larry-athey/larrys-cmd-ctrl/Firmware/README.md

# Firmware Updating

_Keep in mind that this guide and firmware files only serve as an example, there is no way that I can provide firmware files to cover every possible use case. There are brushed motor controllers and stepper motor controllers, a person may or may not be using a GPIO expansion module, there's no way for me to know how many RGB LEDs a person intends to use, etc. Anybody can create their own firmware .bin files from the Arduino IDE by clicking on **Sketch** in the menu bar and then selecting **Export Compiled Binary**._

_This example is being provided for those who have a lot of LCC Slaves and it's not plausible or possible to connect each of them to a USB cable in order to flash them the conventional way. The two firmware files that I do provide here are stock builds of the latest source code without the GPIO expansion module add-on._

---

To put an LCC Slave into firmware update mode, open it in the Mission Control device editor and click the **Update Firmware** button at the bottom of the editor pane and follow the instructions on your screen.

The LCC Slave will start up a WiFi access point with the SSID **"LCC-Slave-Update"** and the password to connect is **"12345678"**.

Now open this URL: **http://192.168.4.1**

<br>

If you are unable to connect, check to make sure that your device pulled an IP address from the LCC Slave. If it does not pull one, you will need to manually configure a static IP address on your device. Here are settings that will work for you if you encounter this problem.

Address: 192.168.4.100<br>
Subnet Mask: 255.255.255.0<br>
Gateway: 192.168.4.1<br>
DNS: 192.168.4.1<br>

Click on the button to browse to your **lcc-slave-(device type).bin** file and click the blue button to start the upload.

Once the upload progress bar has completed, the LCC Slave will reboot and will be running the new firmware.
