larry-athey/larrys-cmd-ctrl/Diagrams/LCC Slave PCB (type 1)/LCC-Slave-Type-1_PCB_layers.png

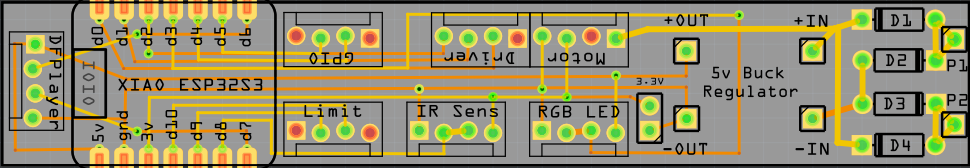
Diagrams/LCC Slave PCB (type 1)/LCC-Slave-Type-1_PCB_layers.png
