larry-athey/larrys-cmd-ctrl/Diagrams/LCC Slave PCB (type 2)/LCC-Slave-Type-2_PCB_top.png

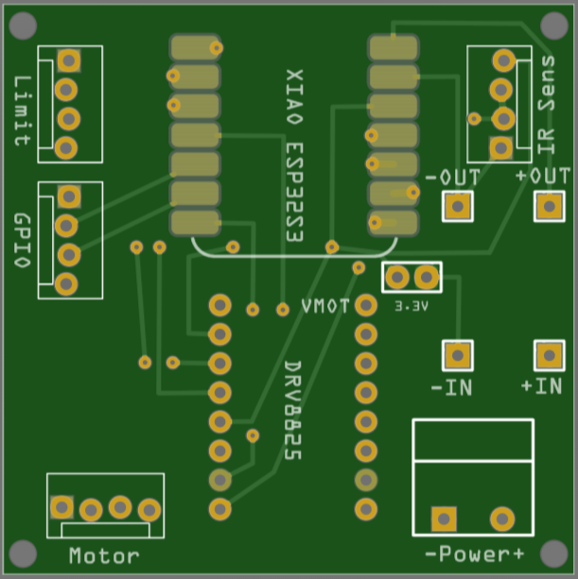
Diagrams/LCC Slave PCB (type 2)/LCC-Slave-Type-2_PCB_top.png
