larry-athey/larrys-cmd-ctrl/Diagrams/LCC Transponder/LCC-Transponder_bottom.png

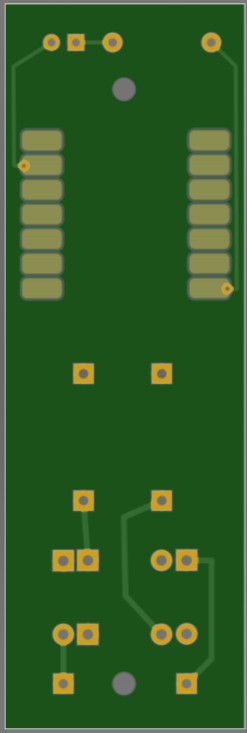
Diagrams/LCC Transponder/LCC-Transponder_bottom.png
