larry-athey/larrys-cmd-ctrl/Diagrams/LCC Transponder/LCC-Transponder_layers.png

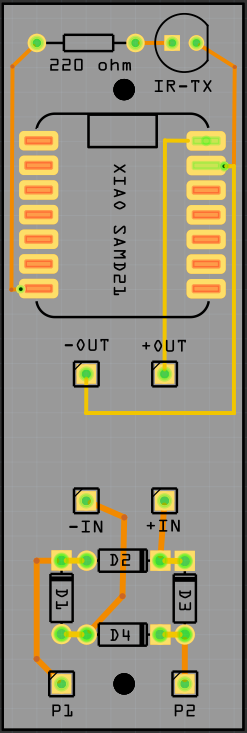
Diagrams/LCC Transponder/LCC-Transponder_layers.png
