larry-athey/larrys-cmd-ctrl/Diagrams/LCC Transponder/LCC-Transponder_top.png

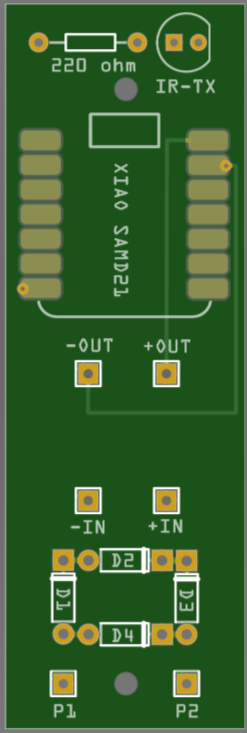
Diagrams/LCC Transponder/LCC-Transponder_top.png
