larry-athey/larrys-cmd-ctrl/Diagrams/Screenshots/Commands.png

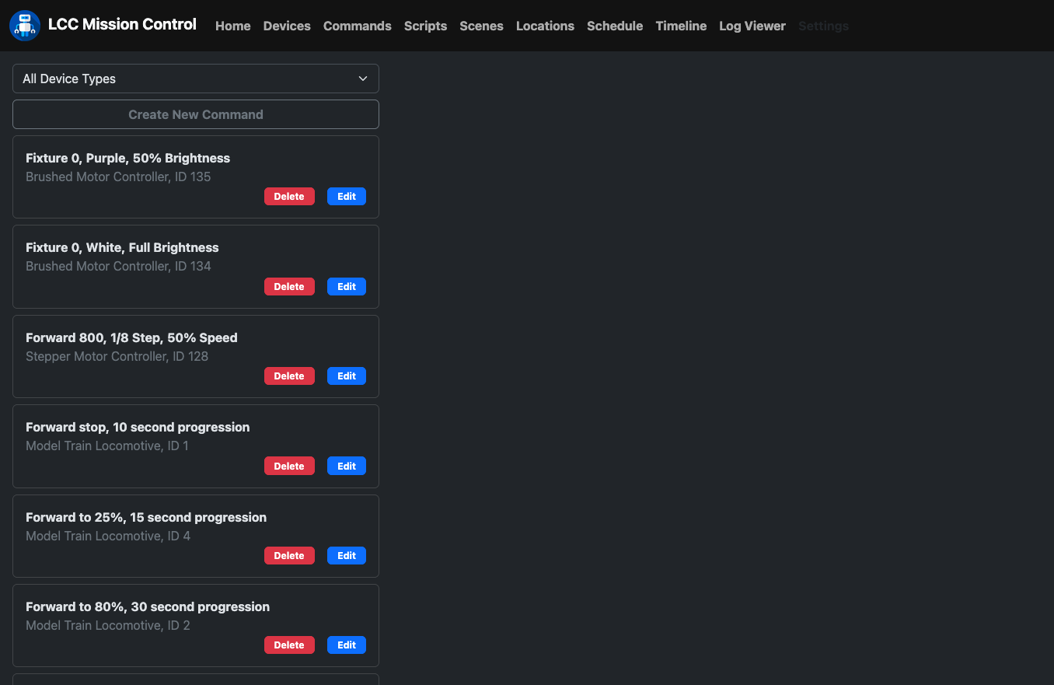
Diagrams/Screenshots/Commands.png
