larry-athey/larrys-cmd-ctrl/Diagrams/Screenshots/Log Viewer.png

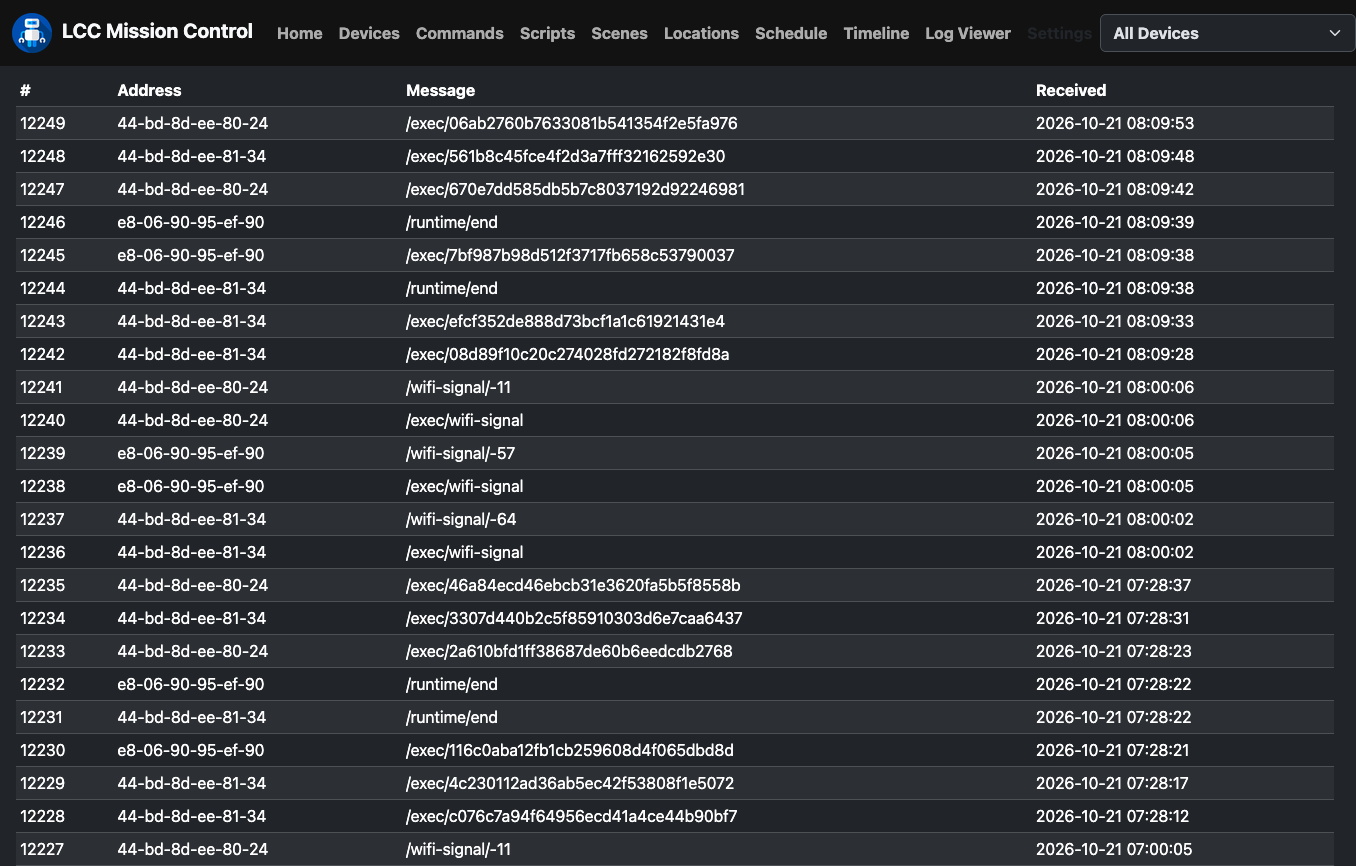
Diagrams/Screenshots/Log Viewer.png
