larry-athey/larrys-cmd-ctrl/Diagrams/Screenshots/Mobile UI.jpg

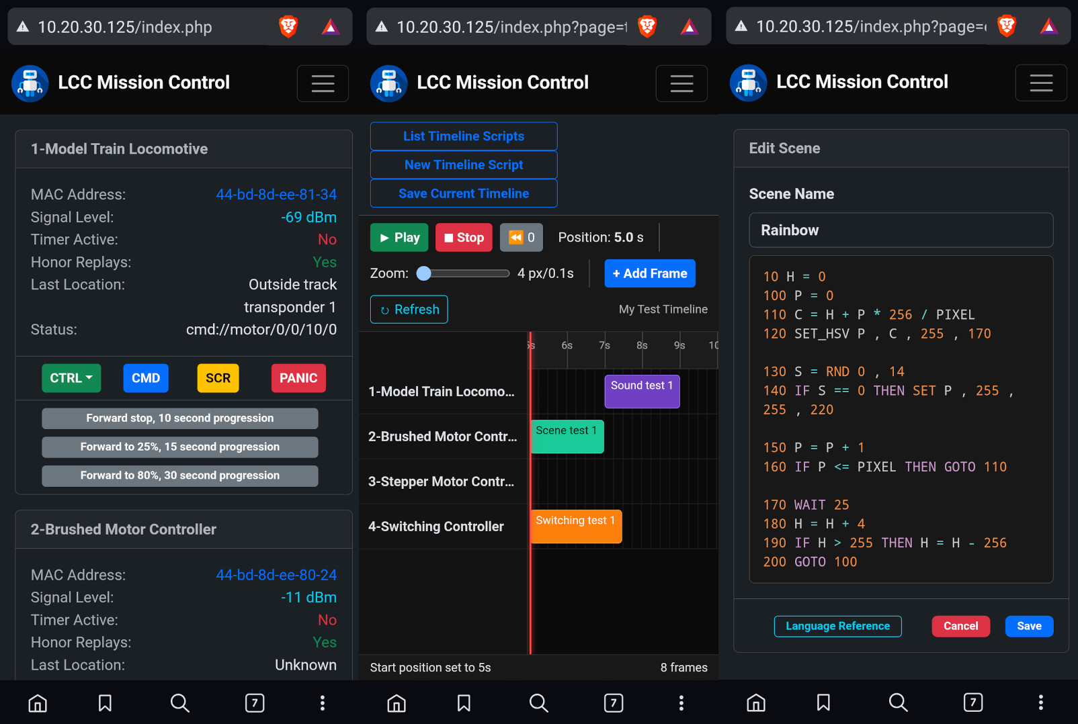
Diagrams/Screenshots/Mobile UI.jpg
