larry-athey/larrys-cmd-ctrl/Diagrams/Screenshots/Scene Editor.png

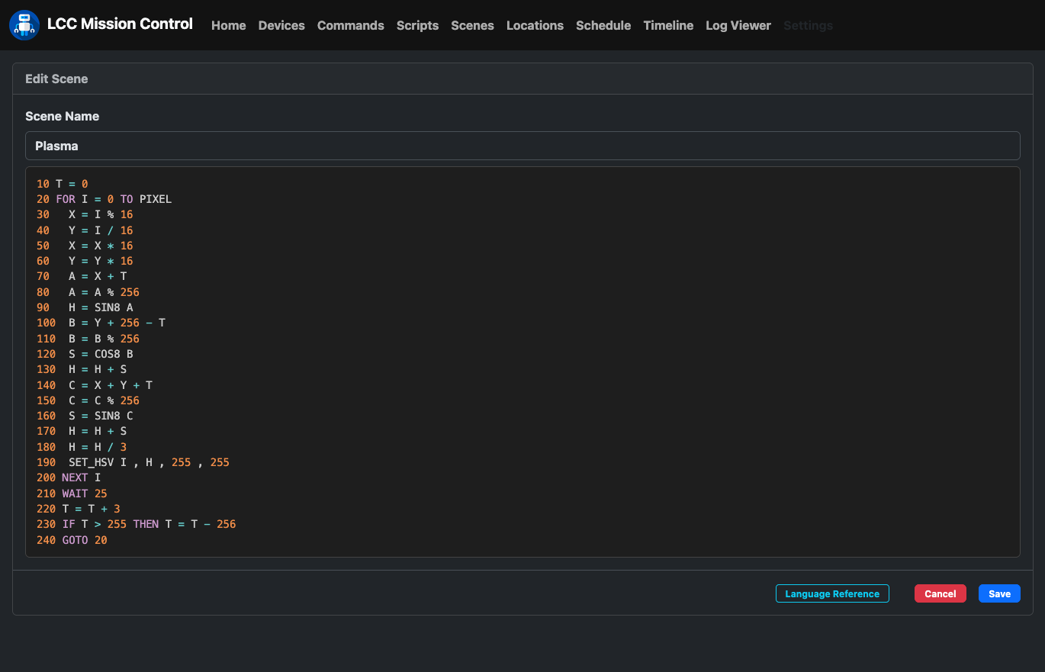
Diagrams/Screenshots/Scene Editor.png
