larry-athey/larrys-cmd-ctrl/Diagrams/Server Driver/Server-Driver-PCB_bottom.png

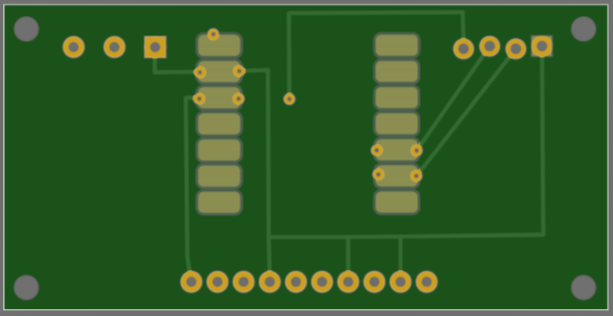
Diagrams/Server Driver/Server-Driver-PCB_bottom.png
