larry-athey/larrys-cmd-ctrl/Diagrams/Server Driver/Server-Driver-PCB_layers.png

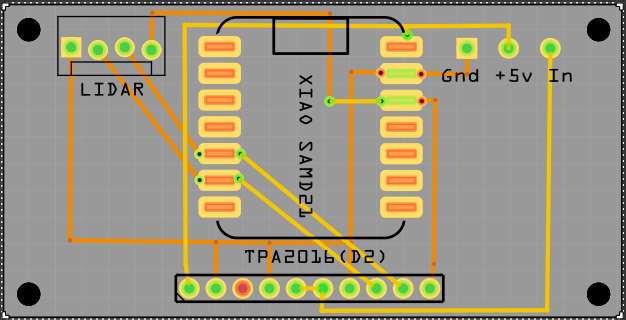
Diagrams/Server Driver/Server-Driver-PCB_layers.png
