larry-athey/larrys-cmd-ctrl/Diagrams/Server Driver/Server-Driver-PCB_top.png

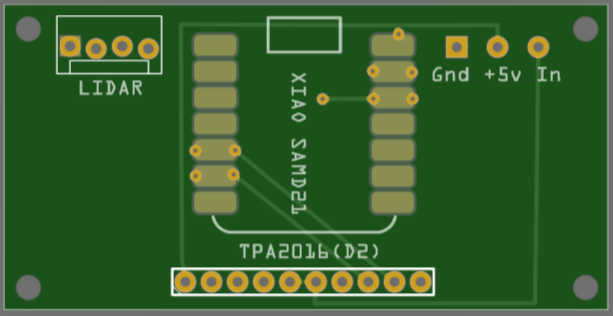
Diagrams/Server Driver/Server-Driver-PCB_top.png
