larry-athey/larrys-cmd-ctrl/3D-Models/Transponder-Top.stl

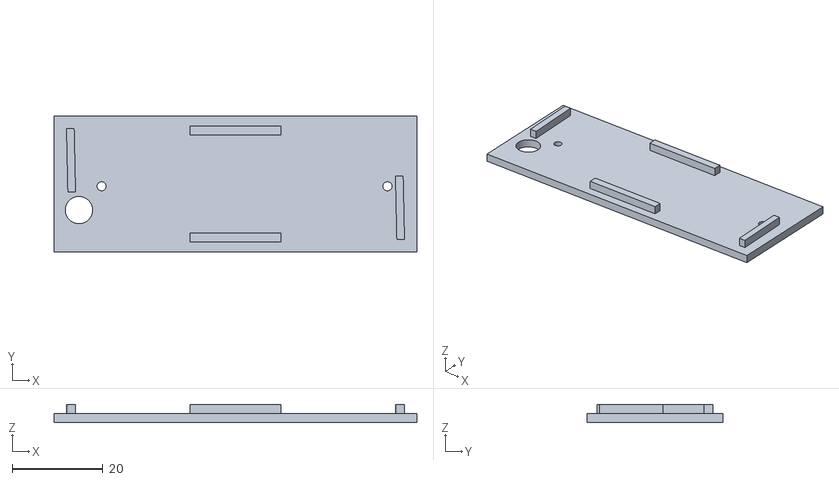
[picture p18: CAD file, 2026-10-28]
3D-Models/Transponder-Top.stl
80.0 x 30.0 x 4.00
