larry-athey/larrys-cmd-ctrl/3D-Models/Transponder-Bottom.stl

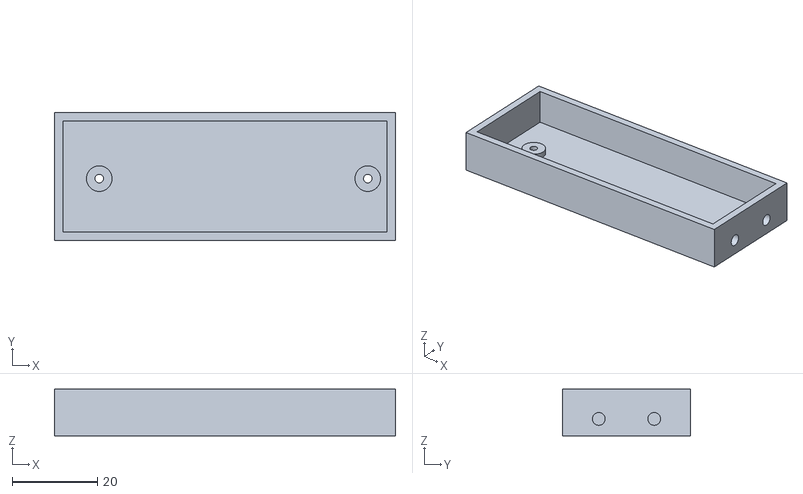
[picture p19: CAD file, 2026-10-28]
3D-Models/Transponder-Bottom.stl
80.0 x 30.0 x 11.0
