larry-athey/larrys-cmd-ctrl/3D-Models/Matchbox-Speaker-Back.stl

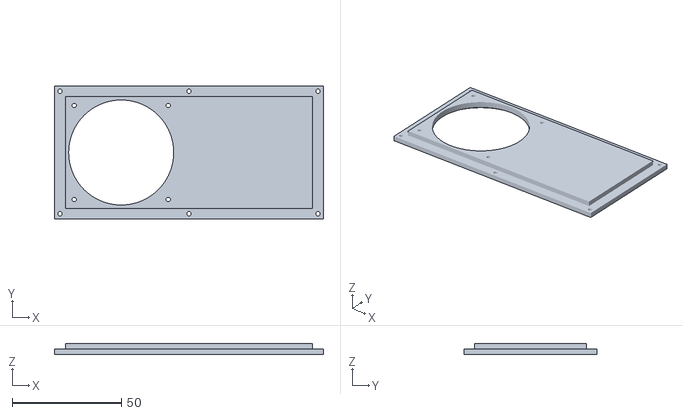
[picture p20: CAD file, 2026-10-16]
3D-Models/Matchbox-Speaker-Back.stl
123.0 x 61.0 x 5.00
