larry-athey/larrys-cmd-ctrl/3D-Models/Matchbox-Speaker-Front.stl

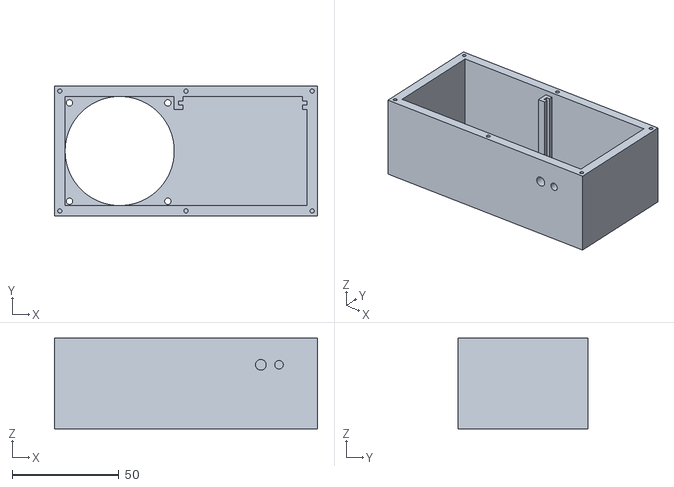
[picture p21: CAD file, 2026-10-16]
3D-Models/Matchbox-Speaker-Front.stl
123.0 x 61.0 x 42.5
