larry-athey/larrys-cmd-ctrl/3D-Models/SD-LIDAR-Mount.stl

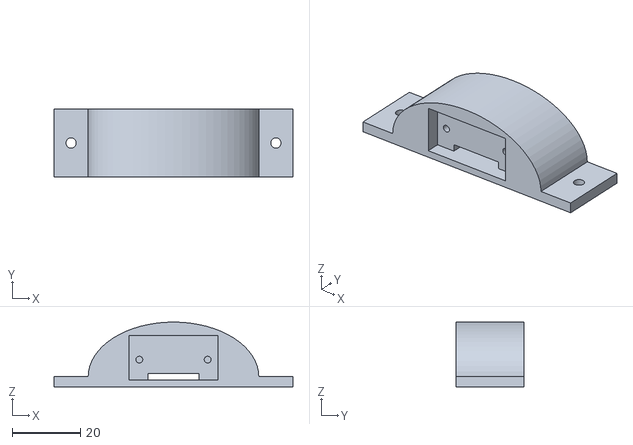
[picture p22: CAD file, 2026-10-15]
3D-Models/SD-LIDAR-Mount.stl
70.0 x 20.0 x 19.0
