larry-athey/larrys-cmd-ctrl/3D-Models/Cube-Speaker-Front.stl

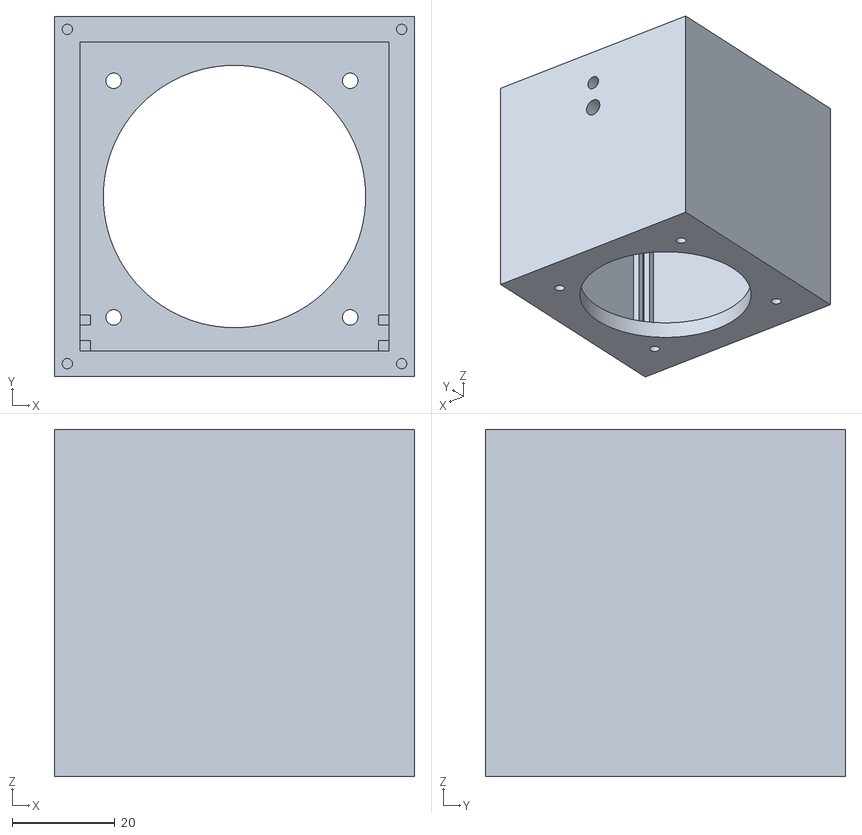
[picture p23: CAD file, 2026-10-15]
3D-Models/Cube-Speaker-Front.stl
70.0 x 70.0 x 67.5
