larry-athey/larrys-cmd-ctrl/3D-Models/Cube-Speaker-Back.stl

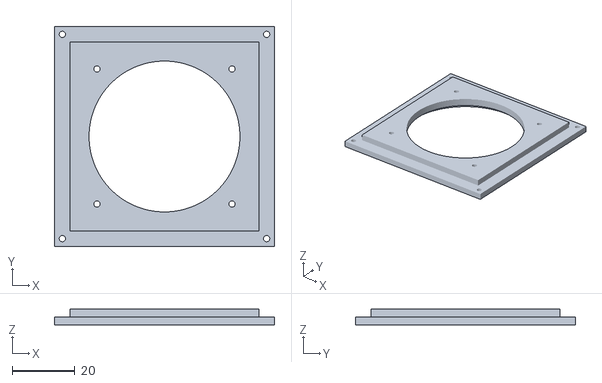
[picture p24: CAD file, 2026-10-15]
3D-Models/Cube-Speaker-Back.stl
70.0 x 70.0 x 5.00
