larry-athey/larrys-cmd-ctrl/(list of files, cad)

Other CAD files:
3D-Models/SS-LIDAR-Mount.stl
