larry-athey/larrys-cmd-ctrl/(commit log)

2026-09-29 Initial publish of the LCC_Slave code for ESP32
2026-09-30 Bug fixes in the timer routines
2026-09-30 Bug fixes in replay requests
    [LCC_Slave.ino, lcc_api.h]
2026-10-01 Implement LedBasic scripting
2026-10-01 Further LedBasic implementation work
2026-10-01 Revamped the command parameters for stepper motor control
2026-10-02 Implement stepper motor support
2026-10-03 Remote switching update
2026-10-03 Replace blocking LED code with non-blocking LedBasic
    [LCC_Slave.ino, lcc_api.h]
2026-10-04 Implement CodeJar editor for LedBasic code.
2026-10-04 Eliminate CSN dependencies for the LedBasic editor
2026-10-05 End stage scene support code additions
2026-10-05 Added device class filtering
2026-10-11 Bug fixes in the stepper motor control code
2026-10-13 LCC Slave PCB type 1
2026-10-13 Move the LCC Slave PCB files to their own folder
2026-10-14 LCC Slave PCB (type 2) upload
2026-10-15 Server Driver PCB upload
2026-10-27 Add transponder PCB case models
2026-10-30 Fix RGB LED fade bug
